CrismaruIlie/SplitFlapDisplay/flaps-generator/All-flaps_v3.3mf

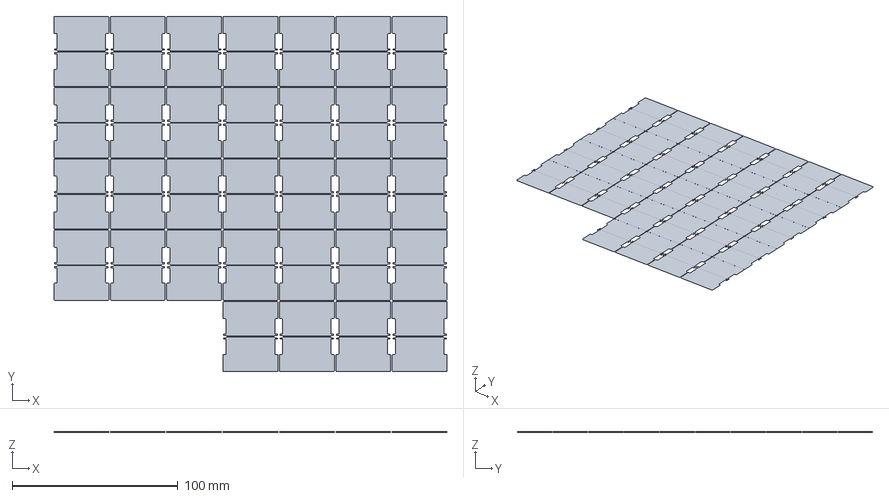
[picture p3: CAD file, 2026-05-19]
flaps-generator/All-flaps_v3.3mf
237.1 x 214.3 x 0.48 mm
