CrismaruIlie/SplitFlapDisplay/flaps-generator/examples/1-flaps.stl

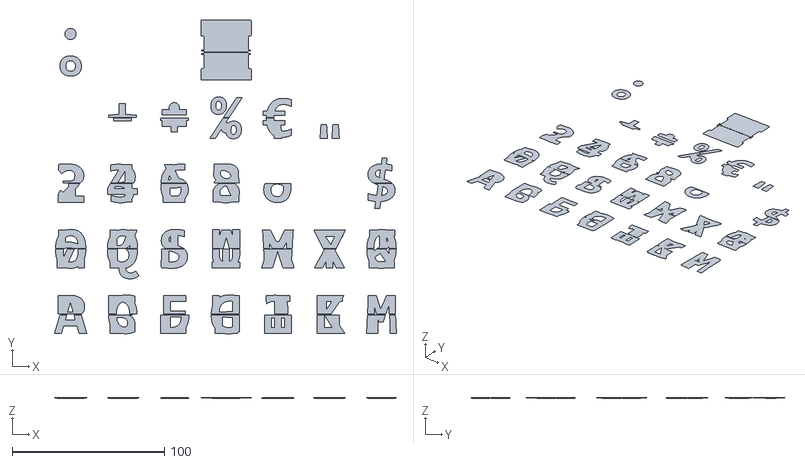
[picture p4: CAD file, 2026-05-19]
flaps-generator/examples/1-flaps.stl
224.4 x 206.0 x 0.48
