CrismaruIlie/SplitFlapDisplay/flaps-generator/Flaps_holding_case.stl

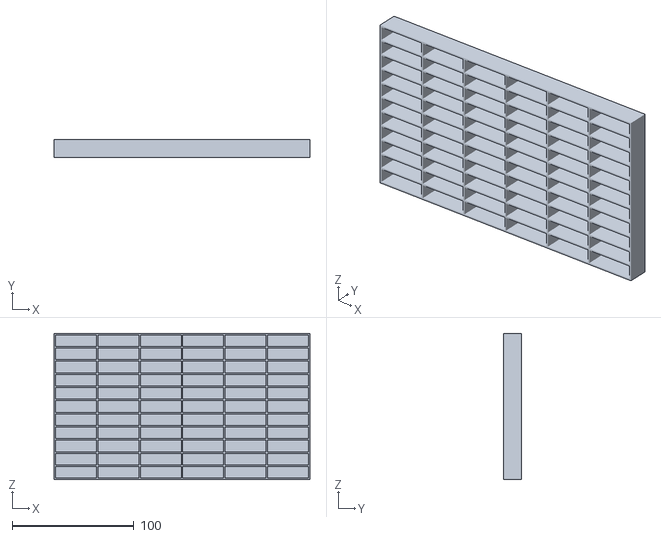
[picture p5: CAD file, 2026-05-17]
flaps-generator/Flaps_holding_case.stl
210.0 x 15.0 x 120.0
