CrismaruIlie/SplitFlapDisplay/flaps-generator/examples/4-flaps.stl

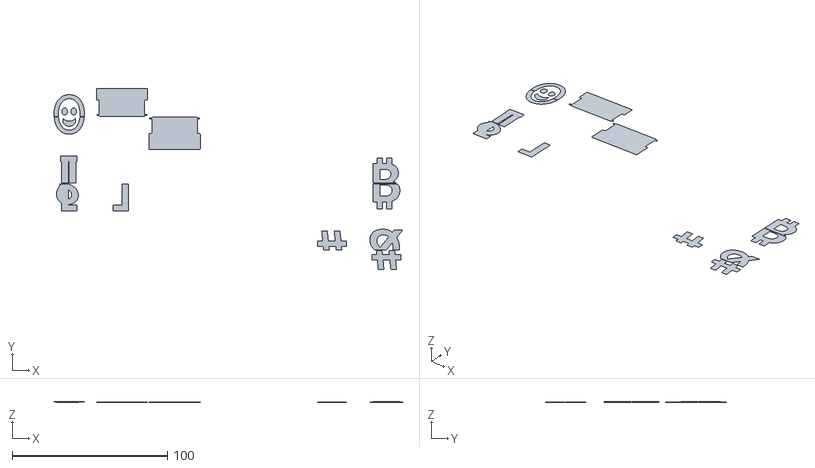
[picture p6: CAD file, 2026-05-19]
flaps-generator/examples/4-flaps.stl
225.1 x 116.6 x 0.48
