CrismaruIlie/SplitFlapDisplay/flaps-generator/examples/3-flaps.stl

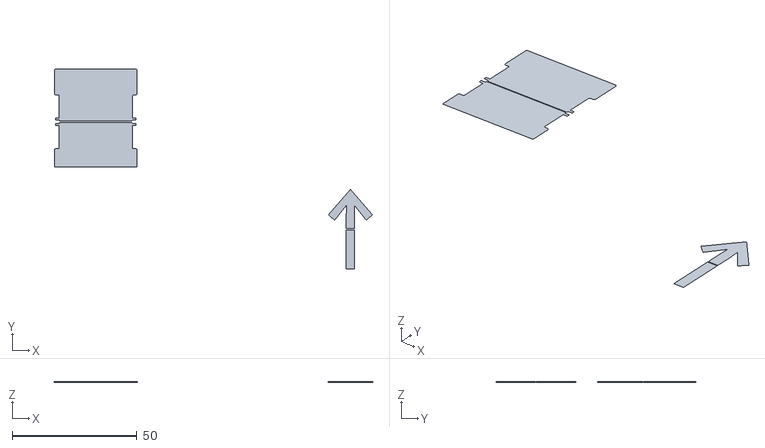
[picture p7: CAD file, 2026-05-19]
flaps-generator/examples/3-flaps.stl
127.4 x 80.1 x 0.16
