CrismaruIlie/SplitFlapDisplay/flaps-generator/examples/2-flaps.stl

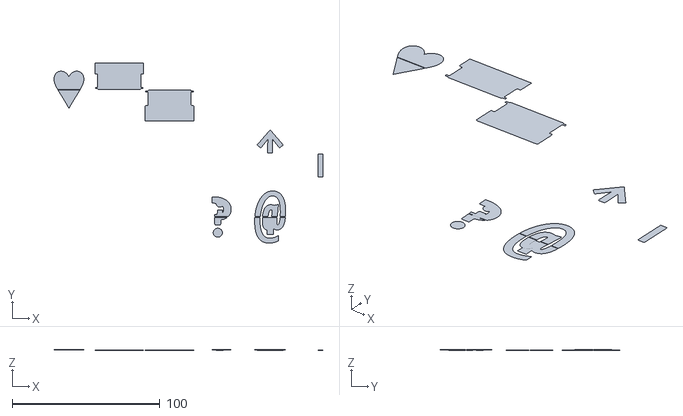
[picture p8: CAD file, 2026-05-19]
flaps-generator/examples/2-flaps.stl
181.8 x 121.8 x 0.48
