CrismaruIlie/SplitFlapDisplay/(list of files, cad)

Other CAD files:
flaps-generator/flaps.scad
flaps-generator/Flaps_holding_case.scad
