CrismaruIlie/SplitFlapDisplay/(commit log)

2026-05-17 Add flaps holding case
    [Flaps_holding_case.scad, Flaps_holding_case.stl]
2026-05-19 Added black bottom margin
    [1-flaps.stl, 2-flaps.stl, 3-flaps.stl, 4-flaps.stl, All-flaps_v3.3mf, Flaps_holding_case.stl, flaps.scad, flaps_arial_28.3mf]
2026-05-20 Added RS484 documentation
    [flaps.scad]
2026-05-28 Updated driver to fix pad issue on RS-485 chip which caused issues with JLCPCB. Removed driver board v2 and v3 files as they are now deprecated.
    [BOM File.xls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]
